Lohith2109/Wireless_Health_Monitoring_System/(commit log)

2026-03-10 Update README with PCB and enclosure guidelines
    Added guidelines for PCB assembly and 3D enclosure adjustments.
2026-03-10 Revise PCB and 3D enclosure guidelines
    Updated guidelines for PCB and 3D enclosure to reflect changes in design and assembly.
